sundarrajnitish/Automated-Hydroponics-Lab/docs/img/controls.jpg

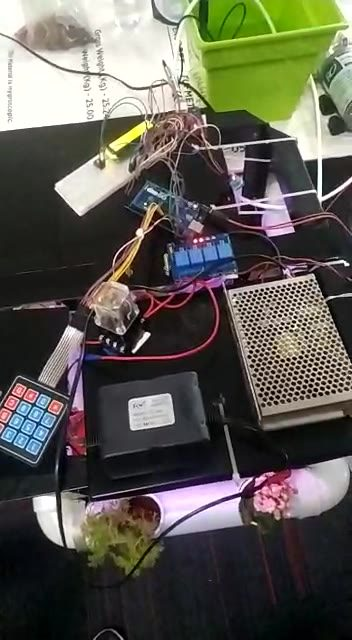
docs/img/controls.jpg
