sundarrajnitish/Automated-Hydroponics-Lab/docs/img/electronics.jpg

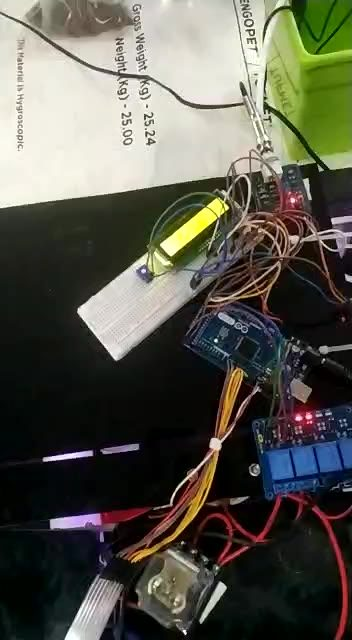
docs/img/electronics.jpg
