sundarrajnitish/Automated-Hydroponics-Lab/(commit log)

2026-09-30 Add controller core with host unit tests
    pH conversion with two-point calibration, dose-and-wait dosing with a
    learned response, photoperiod and pump cycles, low-water interlock,
    fan/humidifier hysteresis, calibration and clock screens.
2026-09-30 Add Arduino sketch: non-blocking hardware layer
    Outputs parked OFF before pinMode, per-channel relay polarity, EEPROM
    settings with CRC-8, watchdog, CSV telemetry.
2026-09-30 Add simulator: virtual Mega, mock Arduino core and reservoir model
    The firmware compiles into it unmodified. Builds natively and to
    WebAssembly with bit-identical results.
